melitvinov/Acidifier/Документация/Описание подкислителя.docx

# Подкислитель

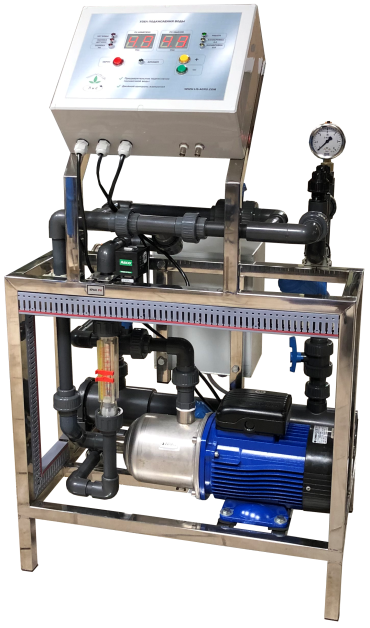
[picture p1: figure]

| Назначение Подкислитель – устройство, предназначенное для автоматического подкисления потока воды до заданного пользователем значения PH.

# Внешний вид, управление и индикация

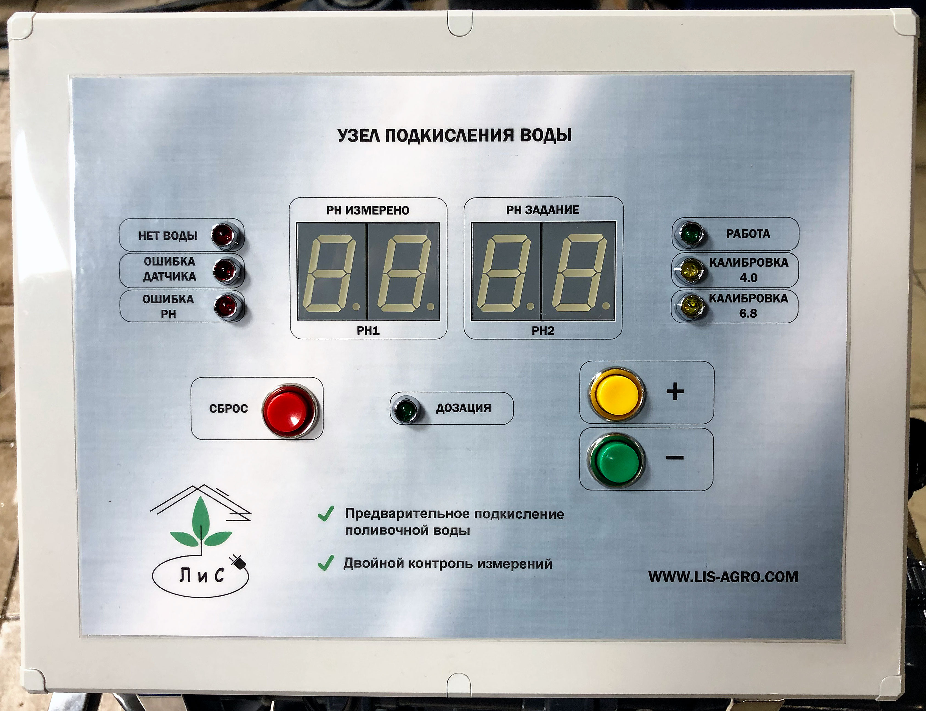
[picture p2: figure]

Рисунок 1

Внешний вид блока управления показан на рисунке 1. Кнопки [+] и[-] позволяют изменять заданное значение PH, а также переводить подкислитель в режим калибровки датчиков. Кнопка [СБРОС] предназначена для отмены режима калибровки, а также для сброса ошибок. Левый двухразрядный цифровой индикатор отображает текущее значение PH воды в режиме работы (полива или наполнения емкости), либо значение PH первого датчика в режиме калибровки. Правый двухразрядный цифровой индикатор отображает заданное пользователем значение PH воды в режиме работы (полива или наполнения емкости), либо значение PH второго датчика в режиме калибровки. Светодиоды отображают различные состояния работы прибора, а также наличие ошибок в работе.

# Работа в режиме подкисления воды

В этот режим подкислитель переходит после включения, либо после завершения (либо отмены) калибровки датчиков PH. Необходимым условием работы подкислителя является наличие потока воды. Когда поток воды есть, на блоке управления загорается светодиодный индикаторы «Работа», и включается встроенный насос.

Для задания нужного значения PH воды используйте кнопки [+] или [-]. Каждое нажатие на кнопку увеличивает, либо уменьшает заданное значение PH на величину 0,1. Правый двухразрядный цифровой индикатор отображает текущее заданное значение.

В этом режиме подкислитель работает пока есть поток воды и отсутствуют ошибки. При возникновении внутренних ошибок или отсутствии воды работа подкислителя останавливается.

# Ошибки, сброс ошибок

1. Ошибка датчиков возникает, если разница измеренных значений между первым и вторым датчиком больше 0,5.
2. Ошибка регулирования возникает, если за период времени (40 сек. по умолчанию) не удается выйти на заданное пользователем значение PH (в диапазоне +-0,5).
3. Отсутствие воды

При возникновении любой из перечисленных ошибок работа подкислителя останавливается.

Для сброса ошибок регулирования и ошибки датчиков (после устранения причины их возникновения) удерживайте кнопку «СБРОС» в течение 3 сек. Ошибка отсутствия воды сбросится автоматически после появления протока воды.

# Калибровка датчиков

В подкислителе используются два датчика PH. Перед началом использования подкислителя, а также в каждый период регламентных работ эти датчики надо откалибровать.

Калибровка производится следующим образом:

- На блоке управления нажать и удерживать одновременно кнопки [+][-] в течение 2-3 сек. При этом на блоке управления загорится светодиод «Калибровка 4.0», а на цифровых индикаторах будут текущие значения по каждому из датчиков, на левом для первого датчика, на правом – для второго.
- Оба датчика погружаются в раствор 4.01 (значение по умолчанию). Делается пауза около 1-2 мин. чтобы датчики адаптировались к раствору.
- Через 1-2 минуты нажать еще раз обе кнопки [+][-] в течение 2-3 сек. Светодиод «Калибровка 4.0» погаснет, а Светодиод «Калибровка 6.8» загорится. При этом для обоих датчиков будут зафиксированы значения калибровочной точки 4.0.
- Оба датчика погружаются в раствор 6.8 (значение по умолчанию). Делается пауза около 1-2 мин. чтобы датчики адаптировались к раствору.
- Через 1-2 минуты нажать еще раз обе кнопки [+][-] в течение 2-3 сек. Светодиод «Калибровка 6.8» погаснет. При этом для обоих датчиков будут зафиксированы значения калибровочной точки 6.8, а подкислитель вернется в состояние работы.

# Эксплуатационные параметры

Давление в системе | 2 кгс
Продолжительность работы | круглосуточная
