melitvinov/Acidifier/PCAD/Перечень элементов Acidifier-v7.xlsx

RefDes | ComponentName | Value | PatternName
A1 | AM2S-1205SZ | AM2S-1205SZ | AM2S-1205SZ
D2 | FM24V02 | FM24V02 | SO-G8
VT3 | BC857_SOT23 |  | SOT-23A
C2 | CTB | 100.0x10V | CTB
C3 | CTB | 100.0x10V | CTB
C1 | CTB | 100.0x20V | CTB
C12 | C_400V | 0,33 mkF | C_400V
C13 | C_400V | 0,33 mkF | C_400V
C7 | C_0805 | 4.7 mkF | 0805
C8 | C_0805 | 4.7mkF | 0805
C9 | C_0805 | 4.7mkF | 0805
C4 | C_0805 | 100nF | 0805
C5 | C_0805 | 100nF | 0805
C6 | C_0805 | 100nF | 0805
C10 | C_0805 | 100nF | 0805
C11 | C_0805 | 100nF | 0805
XP1 | IDC2X5M |  | IDC10M
XP2 | IDC2X5M |  | IDC10M
VT1 | IRLML2502 | IRLML2502 | SOT-23
VT2 | IRLML2502 | IRLML2502 | SOT-23
VT4 | IRLML2502 | IRLML2502 | SOT-23
A2 | IRM-05 |  | IRM-05
D3 | ISO3082 |  | SO-16-W
J1 | JMP1 |  | PLS-2
J2 | JMP1 |  | PLS-2
HL_ALARM1 | LED_1206 | RED | LED_1206
HL_REGIMP1 | LED_1206 | RED | LED_1206
HL_WATER | LED_1206 | RED | LED_1206
HL1 | LED_1206 | RED | LED_1206
HL_PUMP1 | LED_1206 | YELLOW | LED_1206
D1 | LM1117-3.3V | LM1117-3.3V | SOT223
D6 | MOCD207M |  | SO-G8
XS1 | PBD-8 |  | PBD-8
XS2 | PBD-8 |  | PBD-8
P3 | ESR2002400300 |  | RELAY_ESR2002400300
P1 | NRP05_C |  | RELAY_NRP05_C
P2 | NRP05_C |  | RELAY_NRP05_C
R17 | R_2W_V | 100 | R_2W_V
R20 | R_2W_V | 100 | R_2W_V
R6 | R_0805 | 1k | 0805
R7 | R_0805 | 1k | 0805
R8 | R_0805 | 1k | 0805
R9 | R_0805 | 1k | 0805
R18 | R_0805 | 1k | 0805
R19 | R_0805 | 1k | 0805
R21 | R_0805 | 1k | 0805
R22 | R_0805 | 1k | 0805
R23 | R_0805 | 1k | 0805
R24 | R_0805 | 1k | 0805
R25 | R_0805 | 1k | 0805
R27 | R_0805 | 1k | 0805
R28 | R_0805 | 1k | 0805
R31 | R_0805 | 1k | 0805
R32 | R_0805 | 1k | 0805
R1 | R_0805 | 10k | 0805
R2 | R_0805 | 10k | 0805
R26 | R_0805 | 10k | 0805
R29 | R_0805 | 10k | 0805
R30 | R_0805 | 100 | 0805
R3 | R_0805 | 510 | 0805
R4 | R_0805 | 510 | 0805
R5 | R_0805 | 510 | 0805
R10 | R_0805 | 510 | 0805
R11 | R_0805 | 510 | 0805
R12 | R_0805 | 510 | 0805
R13 | R_0805 | 510 | 0805
R14 | R_0805 | 510 | 0805
R15 | R_0805 | 510 | 0805
R16 | R_0805 | 510 | 0805
D4 | STM32F105_LQFP64 | STM32F105 | QFP-64
SW1 | SW_ERD716BM06Z | ERD716BM06Z | ERD716BM06Z
D5 | ULN2803A | ULN2803 | SO-G18
VD2 | VD_BAT54WS |  | SOD323
VD3 | VD_BAT54WS |  | SOD323
VD4 | VD_BAT54WS |  | SOD323
VD5 | VD_BAT54WS |  | SOD323
XS_220V1 | XS_DG142V-5.08-02P |  | XS_DG142V-5.08-02P
XS_ALARM1 | XS_DG142V-5.08-02P |  | XS_DG142V-5.08-02P
XS_BTN1 | XS_DG142V-5.08-02P |  | XS_DG142V-5.08-02P
XS_BTN2 | XS_DG142V-5.08-02P |  | XS_DG142V-5.08-02P
XS_LED1 | XS_DG142V-5.08-02P |  | XS_DG142V-5.08-02P
XS_LED2 | XS_DG142V-5.08-02P |  | XS_DG142V-5.08-02P
XS_LED3 | XS_DG142V-5.08-02P |  | XS_DG142V-5.08-02P
XS_LED4 | XS_DG142V-5.08-02P |  | XS_DG142V-5.08-02P
XS_PUMP1 | XS_DG142V-5.08-02P |  | XS_DG142V-5.08-02P
XS_REG_CTRL1 | XS_DG142V-5.08-02P |  | XS_DG142V-5.08-02P
XS_RS1 | XS_DG142V-5.08-02P |  | XS_DG142V-5.08-02P
XS_WATER1 | XS_DG142V-5.08-02P |  | XS_DG142V-5.08-02P
