melitvinov/Acidifier/PCAD/BOM/BOM_Acidifier - LCD v3.xlsx

ТИП | ИМЯ(ЗНАЧ) | КОРПУС | КОЛ-ВО | ПРОИЗВ(1). | НОМ.НОМЕР(1) | ПРОИЗВ(2). | НОМ.НОМЕР(2) | REF DES
Конденсатор SMD | 100nF | SMD_0805 | 4 | Walsin | 0805 B 104 K 250 | --- No Data --- |  | C3, C4, C5, C6
Конденсатор Tantal SMD | 100.0uFx10V | SMD_Type_B | 1 | Kemet | TAJ B 107 M 010 | AVX | TAJB107M010RNJ | C1
Микросхема | 74HC4094 | SO-G16 | 4 | NXP Semiconductors | 74HC4094D | --- No Data --- |  | D1, D2, D3, D4
Резистор SMD | 100 | SMD_0805 | 28 | Walsin | WR08 X 101 J T | --- No Data --- |  | R1, R2, R3, R4, R5, R6, R7, R9, R11, R13, R14, R16, R18, R19, R23, R24, R26, R27, R28, R30, R32, R34, R35, R36, R37, R38, R39, R40
Резистор SMD | 200 | SMD_0805 | 4 | Walsin | WR08 X 201 J T | --- No Data --- |  | R8, R21, R33, R41
