melitvinov/Acidifier/PCAD/BOM/BOM_Acidifier-v7.xlsx

ТИП | ИМЯ(ЗНАЧ) | КОРПУС | КОЛ-ВО | ПРОИЗВ(1). | НОМ.НОМЕР(1) | ПРОИЗВ(2). | НОМ.НОМЕР(2) | REF DES
Диод | BAT54WS | SOD323 | 4 | Diotec | BAT54WS | --- No Data --- |  | VD2, VD3, VD4, VD5
Конденсатор DIP | 0,33 mkF | C_400V | 2 | --- No Data --- |  | --- No Data --- |  | C12, C13
Конденсатор SMD | 100nF | SMD_0805 | 5 | Walsin | 0805 B 104 K 250 | --- No Data --- |  | C4, C5, C6, C10, C11
Конденсатор SMD | 4.7uF | SMD_0805 | 3 | Walsin | 0805 X 475 K 100 | --- No Data --- |  | C7, C8, C9
Конденсатор Tantal SMD | 100.0uFx10V | SMD_Type_B | 2 | Kemet | TAJ B 107 M 010 | AVX | TAJB107M010RNJ | C2, C3
Конденсатор Tantal SMD | 100.0uFx20V | SMD_Type_B | 1 | Kemet | TAJ B 107 M 020 | --- No Data --- |  | C1
Микросхема | FM24V02 | SO-G8 | 1 | Cypress Semiconductor | FM24V02-G | --- No Data --- |  | D2
Микросхема | ISO3082 | SO-16-W | 1 | Texas Instruments | ISO3082DW | --- No Data --- |  | D3
Микросхема | LM1117-3.3V | SOT223 | 1 | Texas Instruments | LM1117MPX-3.3 | --- No Data --- |  | D1
Микросхема | STM32F105 | QFP-64 | 1 | ST | STM32F105RC | --- No Data --- |  | D4
Микросхема | ULN2803A | SO-G18 | 1 | Texas Instruments | ULN2803ADW | --- No Data --- |  | D5
Модуль | AM2S-1205SZ | AM2S-1205SZ | 1 | --- No Data --- |  | --- No Data --- |  | A1
Модуль | IRM-05 | IRM-05 | 1 | --- No Data --- |  | --- No Data --- |  | A2
Оптрон | MOCD207 | SO-G8 | 1 | ON Semiconductor | MOCD207M | --- No Data --- |  | D6
Переключатель | ERD716BM06Z | ERD7 | 1 | ECE | ERD716BM06Z | --- No Data --- |  | SW1
Разъем | DG142V-5.08-02P | DG142V-5.08-02P | 12 | --- No Data --- |  | --- No Data --- |  | XS_220V1, ...
Резистор DIP | 100 | 2W_V | 1 | --- No Data --- |  | --- No Data --- |  | R17, R20
Резистор SMD | 100 | SMD_0805 | 1 | Walsin | WR08 X 101 J T | --- No Data --- |  | R30
Резистор SMD | 510 | SMD_0805 | 10 | Walsin | WR08 X 511 J T | --- No Data --- |  | R3, R4, R5, R10, R11, R12, R13, R14, R15, R16
Резистор SMD | 10k | SMD_0805 | 4 | Walsin | WR08 X 103 J T | --- No Data --- |  | R1, R2, R26, R29
Резистор SMD | 1k | SMD_0805 | 15 | Walsin | WR08 X 102 J T | --- No Data --- |  | R6, R7, R8, R9, R18, R19, R21, R22, R23, R24, R25, R27, R28, R31, R32
Реле | ESR2002400300 | ESR2002400300 | 1 | --- No Data --- |  | --- No Data --- |  | P3
Реле | NRP05_C | NRP05 | 2 | --- No Data --- |  | --- No Data --- |  | P1, P2
Светодиод SMD | LED_RED | SMD_1206 | 4 | Kingbright | KPTD-3216SECK | Foshan NationStar Optoelectronics | FC-3215HRK-620D | HL1, HL_ALARM1, HL_REGIMP1, HL_WATER
Светодиод SMD | LED_YELLOW | SMD_1206 | 1 | Kingbright |  | --- No Data --- |  | HL_PUMP1
Транзистор | BC857 | SOT-23 | 1 | NXP Semiconductors | BC857 | --- No Data --- |  | VT3
Транзистор | IRLML2502 | SOT-23 | 3 | International Rectifier | IRLML2502TRPBF | --- No Data --- |  | VT1, VT2, VT4
