melitvinov/Acidifier/PCAD/Перечень элементов Acidifier LCD-v3.xlsx

RefDes | ComponentName | PatternName | Value
C1 | CTB | CTB | 100.0x10V
C3 | C_0805 | 0805 | 100 nF
C4 | C_0805 | 0805 | 100 nF
C5 | C_0805 | 0805 | 100 nF
C6 | C_0805 | 0805 | 100 nF
D1 | 74HC4094 | SO16
D2 | 74HC4094 | SO16
D3 | 74HC4094 | SO16
D4 | 74HC4094 | SO16
DLED1 | DIG_SC10-21 | DIG_SC10-21
DLED2 | DIG_SC10-21 | DIG_SC10-21
DLED3 | DIG_SC10-21 | DIG_SC10-21
DLED4 | DIG_SC10-21 | DIG_SC10-21
R1 | R_0805 | 0805 | 100
R2 | R_0805 | 0805 | 100
R3 | R_0805 | 0805 | 100
R4 | R_0805 | 0805 | 100
R5 | R_0805 | 0805 | 100
R6 | R_0805 | 0805 | 100
R7 | R_0805 | 0805 | 100
R8 | R_0805 | 0805 | 200
R9 | R_0805 | 0805 | 100
R11 | R_0805 | 0805 | 100
R13 | R_0805 | 0805 | 100
R14 | R_0805 | 0805 | 100
R16 | R_0805 | 0805 | 100
R18 | R_0805 | 0805 | 100
R19 | R_0805 | 0805 | 100
R21 | R_0805 | 0805 | 200
R23 | R_0805 | 0805 | 100
R24 | R_0805 | 0805 | 100
R26 | R_0805 | 0805 | 100
R27 | R_0805 | 0805 | 100
R28 | R_0805 | 0805 | 100
R30 | R_0805 | 0805 | 100
R32 | R_0805 | 0805 | 100
R33 | R_0805 | 0805 | 200
R34 | R_0805 | 0805 | 100
R35 | R_0805 | 0805 | 100
R36 | R_0805 | 0805 | 100
R37 | R_0805 | 0805 | 100
R38 | R_0805 | 0805 | 100
R39 | R_0805 | 0805 | 100
R40 | R_0805 | 0805 | 100
R41 | R_0805 | 0805 | 200
XP1 | IDC2X5M | IDC10M | IDC2X5M
