melitvinov/Acidifier/Документация/Внешний вид вкладки подкислителя в ПО DeviceSetup.JPG

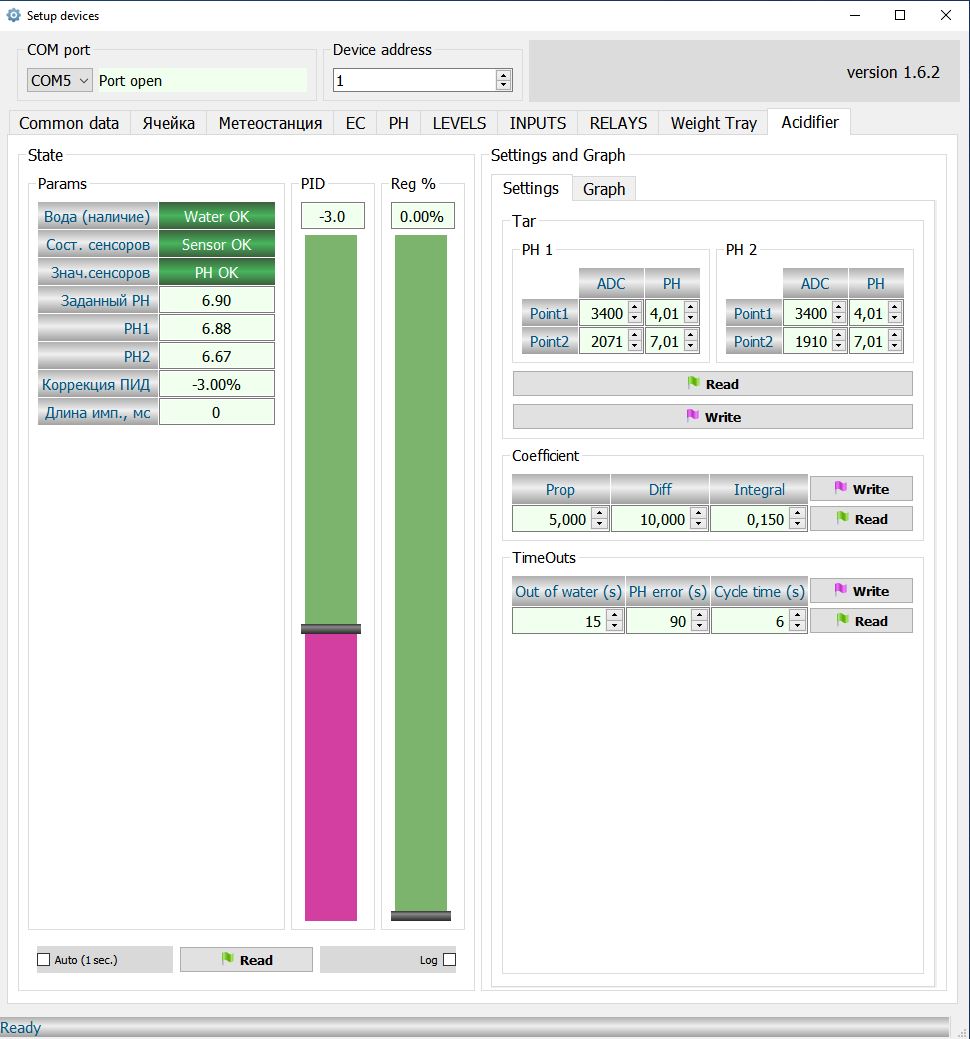
Документация/Внешний вид вкладки подкислителя в ПО DeviceSetup.JPG
