melitvinov/Acidifier/PCAD/Монтажная схема Acidifier-v7.pdf

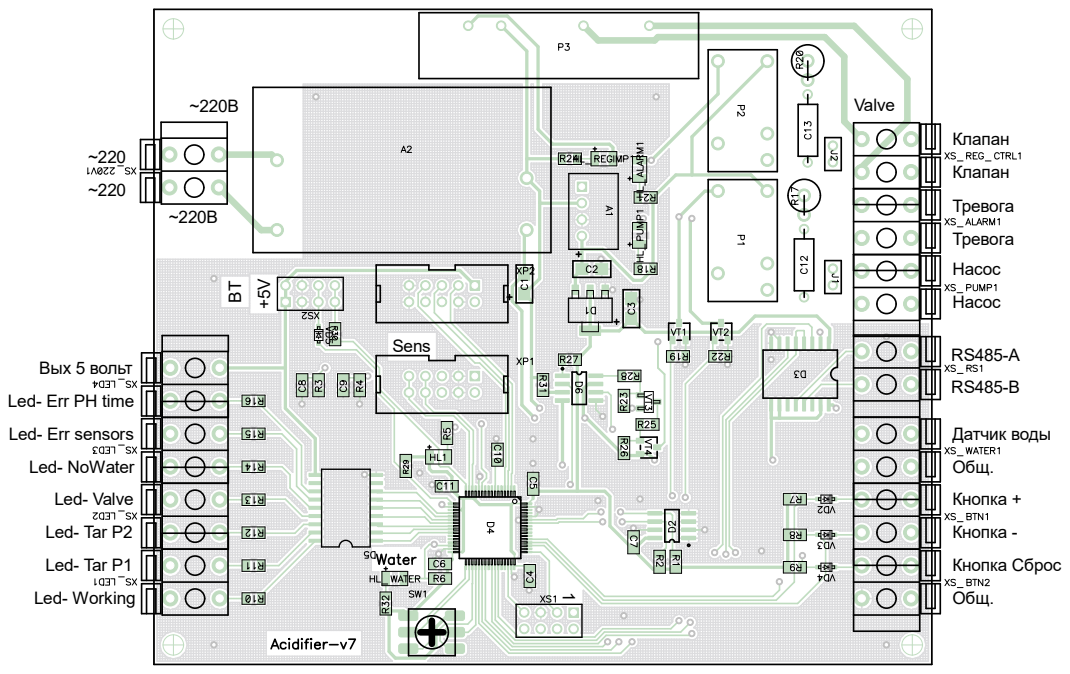
[picture p4: page 1]
Общ.; Кнопка Сброс; Кнопка +; Насос; Тревога; Клапан; Кнопка -; Датчик воды; Sens; Valve BT

Вых 5 вольт
Led- Err PH time
Led- Err sensors
Led- NoWater
Led- Valve
Led- Tar P2
Led- Tar P1
Led- Working
