melitvinov/Acidifier/Функциональная схема подкислителя.pdf

## Регулировка PH

# Функциональная схема подкислителя

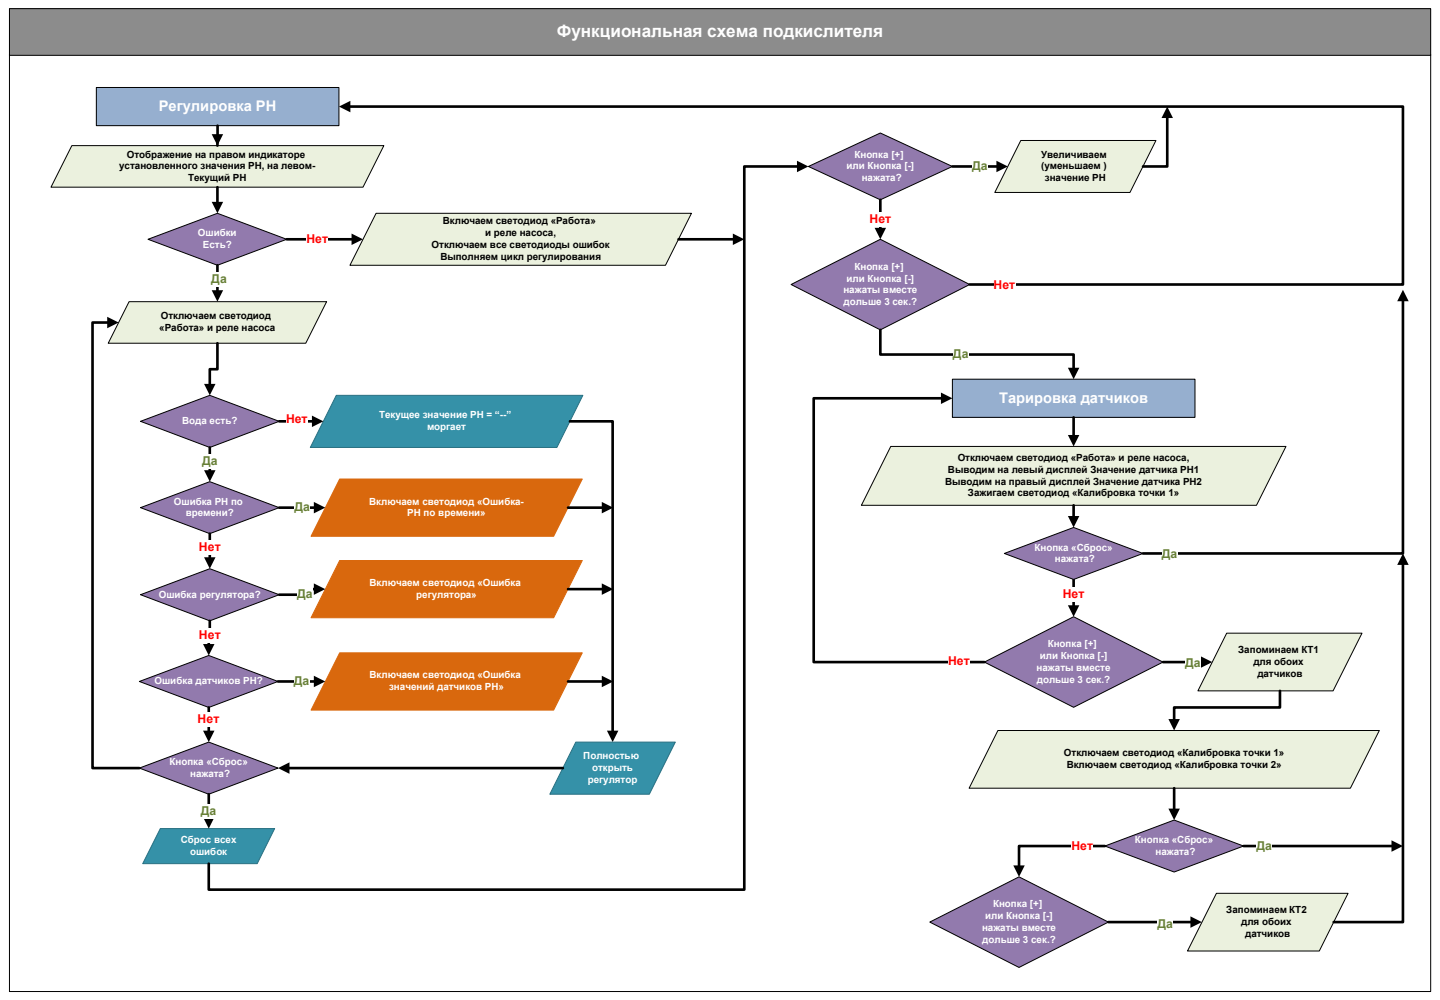
[picture p5: page 1]
Текущий PH; Вода есть?; моргает; Нет; Кнопка [+] или Кнопка [-] нажата?; Увеличиваем (уменьшаем ) значение PH; Кнопка [+] или Кнопка [-] нажаты вместе дольше 3 сек.?; Тарировка датчиков; времени?; регулятора»; Ошибка регулятора?; и реле насоса,; Запоминаем КТ1 для обоих датчиков; Кнопка «Сброс» нажата?; Сброс всех ошибок; Кнопка «Сброс»; нажата?; Запоминаем КТ2 для обоих датчиков; Ошибки Есть?; Полностью открыть регулятор

Отображение на правом индикаторе
установленного значения PH, на левом-

Включаем светодиод «Работа»

Отключаем все светодиоды ошибок
Выполняем цикл регулирования

Отключаем светодиод
«Работа» и реле насоса

Текущее значение PH = “--”

Отключаем светодиод «Работа» и реле насоса,
Выводим на левый дисплей Значение датчика PH1
Выводим на правый дисплей Значение датчика PH2
Зажигаем светодиод «Калибровка точки 1»

Ошибка PH по

Включаем светодиод «Ошибка-

PH по времени»

Включаем светодиод «Ошибка

Ошибка датчиков PH?

значений датчиков PH»

Отключаем светодиод «Калибровка точки 1»
Включаем светодиод «Калибровка точки 2»
