melitvinov/Acidifier/PCAD/Монтажная схема Acidifier LCD-v3.pdf

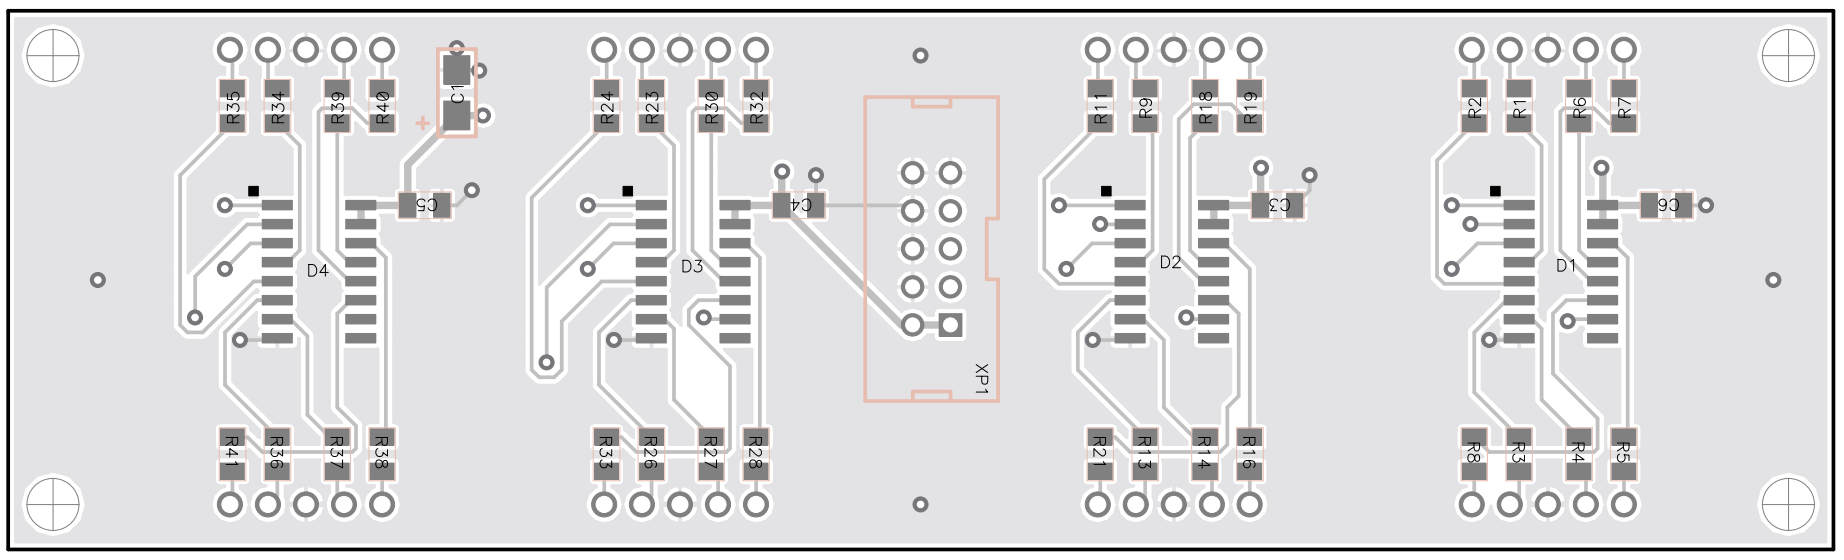
[picture p6: page 1]
