melitvinov/Acidifier/(list of files, drawings)

Other design files:
PCAD/Acidifier - LCD_v3.pcb
PCAD/Acidifier-v7.pcb
