melitvinov/Acidifier/SOFT/Sources/Regulator.c

/***********************************************************************************
* Наименование модуля	: Управление регулятором PH
*-----------------------------------------------------------------------------------
* Версия				: 1.0
* Автор					: Тимофеев
* Дата создания			: 10.03.2021
************************************************************************************/

//--- INCLUDES -------------------
#include "Regulator.h"
#include "Leds.h"
#include "AnaInputs.h"
#include "leds-dig.h"
#include "Rs485.h"

//--- CONSTANTS ------------------

const float K_PROP_DEFAULT 					= 7.0;
const float K_DIFF_DEFAULT 					= 0.0;
const float K_INTEGRAL_DEFAULT 				= 0.0;
const uint16_t REG_CYCLETIME_SEC_DEFAULT 	= 6;

const uint16_t MIN_REG_CYCLETIME_SEC 		= 3;	// минимальный период регулятора в секундах
const uint16_t MAX_REG_CYCLETIME_SEC 		= 10;	// максимальный период регулятора в секундах

const uint32_t TIMEOUT_SENSORS_TOO_DIFF_MS 	= 30000; // тайм-аут в мс для ошибки при разнице показаний датчиков PH больше порогового значения	
const float MAX_PH_DELTA_FOR_ERROR			= 1.0;	// отклонение от задания для старта таймера ошибки по регулированию pH
//const uint16_t MIN_REGULATOR_PERCENT 		= 5;	// минимально возможное открытие регулятора в %
//const uint16_t MAX_REGULATOR_PERCENT		= 95;	// максимально возможное открытие регулятора в %
const uint16_t MIN_REGULATOR_PERCENT 		= 0;	// минимально возможное открытие регулятора в %
const uint16_t MAX_REGULATOR_PERCENT		= 100;	// максимально возможное открытие регулятора в %
const uint16_t MAX_ABS_PID 					= 30;	// максимально возможное значение PID

const int MIN_REGIMP_PACK_TIME_MS = 250;			// минимальная длина импульса регулятора в пачке
const int MIN_REGIMP_ONE_TIME_MS = 200;				// минимальная длина импульса регулятора в пачке

//--- GLOBAL VARIABLES -----------
extern float g_Sensor_PH;					// текущее значение PH с датчиков
extern float g_Setup_PH;					// заданное пользователем значение PH

extern bool g_isNoWater;
//bool is_WaterOk_prev = false;
extern bool g_isErrTimeoutSetupPh;
extern bool g_isErrSensors;

float g_K_INTEGRAL;
float g_K_DIFF;
float g_K_PROP;

uint16_t g_TIMEOUT_REGULATOR_ON_SEC;	// задержка включения регулятора и насоса после подачи воды (сек.)
uint16_t g_TIMEOUT_ERROR_PH_SEC;		// длительность отклонения величины PH от заданного до установки ошибки (сек.)
uint16_t g_REGULATOR_CYCLETIME_SEC;		// период регулирования (сек)
uint16_t g_DELAY_PUMP_OFF_SEC;			// задержка отключения насоса (сек)

float g_flRegPercentOn;					// текущее (последнее значение процента открытия регулятора в %)
float g_PID_Value;						// текущее значение PID
float g_flDeltaPercent;					// текущее значение уменьшения или увеличения процента открытия
int g_ImpulseTime_ms;					// длительность открытия клапана в мс.
float g_PID_IntegralValue = 0;			// накопленный интегральный компонент для расчета PID
float g_prev_PhValue = 7;				// предыдущее значение Ph  для расчета PID

//int g_TimeToStartReg_ms;				// оставшееся время до начала дозации после включения насоса в мс
//int g_TimeToStartCalcPID_ms;			// оставшееся время до начала вычисления PID в мс
bool g_RegulatorStarted;				// флаг - регулятор работает
bool g_CalcPidStarted;					// флаг - расчет PID работает

// таблица оптимальных начальных значений регулятора для трех ph значений 
TOptTablePoint g_OptTablePoints[3];		

//TimerHandle_t TimerPump;
TimerHandle_t TimerRegulatorStartDelay;
//TimerHandle_t TimerCalcPid;

extern uint8_t g_WdtRegulator;
extern uint8_t g_WdtKlapan;
extern uint8_t g_WdtPid;

//--- FUNCTIONS ------------------
extern int ReadWorkMode( uint16_t idx );

void Thread_Klapan( void *pvParameters );
void switch_VALVE( uint8_t on );
void switch_PUMP( uint8_t on );

/*******************************************************
Функция		: Остановка насоса по таймеру
Возвр. знач.: нет
********************************************************/
//void OnTimerPump( TimerHandle_t xTimer )
//{
//	configASSERT( xTimer );
//	
//	xTimerStop( xTimer, 0 );
//	switch_PUMP(0);
//}

/*******************************************************
Функция		: Старт регулятора по таймеру
Возвр. знач.: нет
********************************************************/
void OnTimerRegulatorStartDelay( TimerHandle_t xTimer )
{
	configASSERT( xTimer );
	
	xTimerStop( xTimer, 0 );

	// Устанавливаем значение регулятора
	int index;
	if( g_Setup_PH >= 6 ) index = 0;
	else if( g_Setup_PH >= 5 ) index = 1;
	else index = 2;
	if( g_OptTablePoints[index].ph_setup_user != 0xFFFF && g_OptTablePoints[index].reg_value_opt_calc != 0xFFFF )
	{
		g_flRegPercentOn = ((float)g_OptTablePoints[index].reg_value_opt_calc) / 10.0;
		g_flRegPercentOn /= 2;	// в начале регулирования ставим только половину сохраненного значения
	}
	else
		g_flRegPercentOn = ((float)g_OptTablePoints[index].reg_value_opt_def) / 10.0;

	if( g_flRegPercentOn > MAX_REGULATOR_PERCENT || g_flRegPercentOn < MIN_REGULATOR_PERCENT )
	{
		// !!! Ошибка
		g_flRegPercentOn = MIN_REGULATOR_PERCENT;			// если при начальной установке положения регулятора произошла ошибка, ставим 5% открытия
	}
	
//	xTimerStart( TimerCalcPid, 0 );
	
	g_RegulatorStarted = true;
}

/*******************************************************
Функция		: Старт расчета PID по таймеру
Возвр. знач.: нет
********************************************************/
/*
void OnTimerCalcPid( TimerHandle_t xTimer )
{
	configASSERT( xTimer );
	
	xTimerStop( xTimer, 0 );
	g_CalcPidStarted = true;
}
*/

/*******************************************************
Функция		: Включение регулятора. (после подачи воды)
Возвр. знач.: нет
********************************************************/
void Regulator_START(void) 
{
	// Инициализируем переменные для расчета PID
	g_PID_Value = 0;					// текущее значение PID
	g_flDeltaPercent = 0;				// текущее значение уменьшения или увеличения процента открытия
	g_PID_IntegralValue = 0;			// накопленный интегральный компонент для расчета PID
	g_prev_PhValue = 7;					// предыдущее значение Ph  для расчета PID
	
	TickType_t timerPeriod = g_TIMEOUT_REGULATOR_ON_SEC > 0 ? (g_TIMEOUT_REGULATOR_ON_SEC * 1000) : 100;
	const TickType_t timerTryPeriod = 100;
	
	// устанавливаем таймер на старт процесса регулирования
	if( xTimerChangePeriod( TimerRegulatorStartDelay, timerPeriod, timerTryPeriod ) == pdPASS )
	{
		// The command was successfully sent.
		// OnTimerRegulatorStartDelay() вызовется после срабатывания таймера
	}
	else
	{
		// The command could not be sent, even after waiting for 100 ticks
		// to pass.  Take appropriate action here.
		OnTimerRegulatorStartDelay( TimerRegulatorStartDelay );
	}
	
	// Останавливаем таймер насоса
//	configASSERT( TimerPump );
//	xTimerStop( TimerPump, 0 );

	// Включаем насос
	switch_PUMP( 1 );
}

void Regulator_STOP(void) 
{
//	configASSERT( TimerPump )
//	configASSERT( TimerCalcPid )
	configASSERT( TimerRegulatorStartDelay )

	xTimerStop( TimerRegulatorStartDelay, 0 );
//	xTimerStop( TimerCalcPid, 0 );
	
	g_flDeltaPercent = 0;
	g_flRegPercentOn = MIN_REGULATOR_PERCENT;
	g_PID_Value = 0;
	g_PID_IntegralValue = 0;
	g_RegulatorStarted = false;
	g_CalcPidStarted = false;
	
//	// Выключаем насос через задержку
//	xTimerChangePeriod( TimerPump, g_DELAY_PUMP_OFF_SEC > 0 ? (g_DELAY_PUMP_OFF_SEC * 1000) : 100, 0 );
//	
//	BaseType_t result = xTimerStart( TimerPump, 50 );
//	if( result != pdPASS )
//	{ /* The timer could not be set into the Active
//	   state. */
//	
//		// через таймер не вышло, отключаем сразу
		switch_PUMP( 0 ); 
//	}
}

/*******************************************************
Функция		: Вкл. / выкл. насоса
Параметр 1	: нет
Возвр. знач.: нет
********************************************************/
void switch_PUMP( uint8_t on )
{
	Led_OnOff( LED_WORK_OK, on );
	GPIO_PinWrite( PORT_RELAY_PUMP, PIN_RELAY_PUMP, on );
}

bool IsPumpTurnON( void )
{
	bool isOn = GPIO_PinRead( PORT_RELAY_PUMP, PIN_RELAY_PUMP ) == 0 ? false : true;
	return isOn;
}
/*******************************************************
	Возвращает состояние датчика протока воды
********************************************************/
bool IsWaterOk( void )
{
	bool isOk;
	isOk = ( GPIO_PinRead( PORT_SENS_WATER, PIN_SENS_WATER ) == 0 );
	
	return isOk;
}

/*******************************************************
	Возвращает флаг нужно сейчас регулировать или нет
********************************************************/
bool IsRegulatingOn( void )
{
	bool isOn;
	
	isOn = (!g_isNoWater && !g_isErrSensors && !g_isErrTimeoutSetupPh && g_RegulatorStarted );
	
	return isOn;
}

/*******************************************************
Функция		: Вкл. / выкл. клапана
Параметр 1	: нет
Возвр. знач.: нет
********************************************************/
void switch_VALVE( uint8_t on )
{
	if( on == 0 ) {
		Led_OnOff( LED_VALVE, 0 );
		GPIO_PinWrite( PORT_RELAY_VALVE , PIN_RELAY_VALVE, 1 );
	}
	else /*if( IsPumpTurnON() )*/ {
		Led_OnOff( LED_VALVE, 1 );
		GPIO_PinWrite( PORT_RELAY_VALVE , PIN_RELAY_VALVE, 0 );
	}
}

void setUpDefaultOptTable( void )
{
	// Инициализируем значениями по умолчанию таблицу оптимальных настроек
	for( int i=0; i<3; i++ )
	{
		g_OptTablePoints[i].ph_setup_def = 65 - (i*10);				// PH 		= 6.5	5.5		4.5
		g_OptTablePoints[i].reg_value_opt_def = (10 + (i*20)) * 10; // Value 	= 10	30		50
		g_OptTablePoints[i].ph_setup_user = 0xFFFF;					// PH 		= 0xFFFF - нет значения
		g_OptTablePoints[i].reg_value_opt_calc = 0xFFFF;			// Value 	= 0xFFFF - нет значения
	}
	FM24_WriteBytes( EEADR_OPT_TABLE, (uint8_t*) &g_OptTablePoints, sizeof(g_OptTablePoints) );
}

/*******************************************************
Функция		: Инициализация железа
Параметр 1	: нет
Возвр. знач.: нет
********************************************************/
void Reg_Init(void)
{
	GPIO_PinRemapConfig( GPIO_Remap_SWJ_JTAGDisable, ENABLE );

	// Перевод вывода на вход с подтяжкой к VCC для датчика воды
	GPIO_PinConfigure( PORT_SENS_WATER, PIN_SENS_WATER, GPIO_IN_PULL_UP, GPIO_MODE_INPUT );
	
	// Перевод выводов реле насоса и клапана на выход
	GPIO_PinConfigure( PORT_RELAY_PUMP, PIN_RELAY_PUMP, GPIO_OUT_PUSH_PULL, GPIO_MODE_OUT2MHZ );
	GPIO_PinConfigure( PORT_RELAY_VALVE, PIN_RELAY_VALVE, GPIO_OUT_PUSH_PULL, GPIO_MODE_OUT2MHZ );
	
	// Отключение насоса и клапана
	GPIO_PinWrite( PORT_RELAY_PUMP, PIN_RELAY_PUMP, 0 );
	Led_OnOff( LED_WORK_OK, 0 );
	switch_VALVE( 0 );
	
	// Загружаем коэффициенты для расчета
	uint16_t Koef[3];
	bool needSetupDef = false;
	
	if( !FM24_ReadWords( EEADR_COEF_PROP, &(Koef[0]), 3 ) )
		needSetupDef = true;
	else if( Koef[0] == 0 ) //|| Koef[1] == 0 )
		needSetupDef = true;

	if( needSetupDef )
	{
		g_K_PROP = K_PROP_DEFAULT;
		g_K_INTEGRAL = K_INTEGRAL_DEFAULT;
		g_K_DIFF = K_DIFF_DEFAULT;
		Koef[0] = g_K_PROP * 1000;
		Koef[1] = g_K_INTEGRAL * 1000;
		Koef[2] = g_K_DIFF * 1000;
		
		FM24_WriteWords( EEADR_COEF_PROP, &(Koef[0]), 3 );
	}
	else
	{
		g_K_PROP = (float)Koef[0] / 1000.0;
		g_K_INTEGRAL = (float)Koef[1] / 1000.0;
		g_K_DIFF = (float)Koef[2] / 1000.0;
		
	}

	if( !FM24_ReadWords( EEADR_TIMEOUT_REGULATOR_ON_SEC, &g_TIMEOUT_REGULATOR_ON_SEC, 1 ) || g_TIMEOUT_REGULATOR_ON_SEC == 0 )
	{
		g_TIMEOUT_REGULATOR_ON_SEC = 5;
		FM24_WriteWords( EEADR_TIMEOUT_REGULATOR_ON_SEC, &g_TIMEOUT_REGULATOR_ON_SEC, 1 );
	}

	if( !FM24_ReadWords( EEADR_TIMEOUT_ERROR_PH_SEC, &g_TIMEOUT_ERROR_PH_SEC, 1 ) || g_TIMEOUT_ERROR_PH_SEC == 0 )
	{
		g_TIMEOUT_ERROR_PH_SEC = 90;
		FM24_WriteWords( EEADR_TIMEOUT_ERROR_PH_SEC, &g_TIMEOUT_ERROR_PH_SEC, 1 );
	}

	if( !FM24_ReadWords( EEADR_REG_CYCLETIME_SEC, &g_REGULATOR_CYCLETIME_SEC, 1 ) || g_REGULATOR_CYCLETIME_SEC == 0 )
	{
		g_REGULATOR_CYCLETIME_SEC = REG_CYCLETIME_SEC_DEFAULT;
		FM24_WriteWords( EEADR_REG_CYCLETIME_SEC, &g_REGULATOR_CYCLETIME_SEC, 1 );
	}
	
	// инициализируем таблицу оптимальных значений регулятора в зависимости от установки PH
	if( !FM24_ReadBytes( EEADR_OPT_TABLE, (uint8_t*) &g_OptTablePoints, sizeof(g_OptTablePoints) ) )
	{
		setUpDefaultOptTable();
	}
	else 
	{
		bool needDef = false;
		for( int i=0; i<3; i++ )
			needDef |= g_OptTablePoints[i].ph_setup_def < 40 || g_OptTablePoints[i].ph_setup_def > 70;

		if( needDef )
			setUpDefaultOptTable();
	}

	if( !FM24_ReadWords( EEADR_DELAY_PUMP_OFF_SEC, &g_DELAY_PUMP_OFF_SEC, 1 ) || ( !g_DELAY_PUMP_OFF_SEC ) )
	{
		g_DELAY_PUMP_OFF_SEC = 5;
		FM24_WriteWords( EEADR_DELAY_PUMP_OFF_SEC, &g_DELAY_PUMP_OFF_SEC, 1 );
	}
	if( g_DELAY_PUMP_OFF_SEC > 20 ) {
		g_DELAY_PUMP_OFF_SEC = 20;
		FM24_WriteWords( EEADR_DELAY_PUMP_OFF_SEC, &g_DELAY_PUMP_OFF_SEC, 1 );
	}		
}

/*******************************************************
Поток		: Расчет величины PID 
Параметр 1	: не используется
Возвр. знач.: бесконечный цикл
********************************************************/
/*
void Thread_Pid( void *pvParameters )
{
	float prop_value, integ_value, diff_value, error_ph, tmp_Pid;

	TickType_t xLastWakeTime  = xTaskGetTickCount();
	const TickType_t PERIOD_MS = 1000;
	
	for(;;)
	{
		g_WdtPid = 1;
		
		vTaskDelayUntil( &xLastWakeTime, PERIOD_MS );

		if( IsRegulatingOn() && g_CalcPidStarted )
		{
			// при наличии воды и отсутсвии ошибок вычисляем величину PID
			// ошибка Ph
			error_ph = g_Sensor_PH - g_Setup_PH;
			// пропорциональный компонент
			prop_value = g_K_PROP * error_ph;
			
			// интегральный компонент
			integ_value =  g_K_INTEGRAL * error_ph;
			// добавляем накопленный интегральный компонент
			integ_value += g_PID_IntegralValue;
			// сохраняем текущее значение накопленного интегрального компонента
			g_PID_IntegralValue = integ_value;
			
			// дифференциальный компонент
			diff_value = g_Sensor_PH - g_prev_PhValue;
			diff_value *= g_K_DIFF;
			
			// сохраняем текущее значение Ph для будущих расчетов
			g_prev_PhValue = g_Sensor_PH;

			tmp_Pid = prop_value + integ_value + diff_value;
			
			if( fabs( tmp_Pid ) > MAX_ABS_PID )
			{
				if( tmp_Pid >= 0 ) 
					tmp_Pid = MAX_ABS_PID;
				else {
					tmp_Pid = MAX_ABS_PID;
					tmp_Pid *= -1.0;
				}
			}
			
			//tmp_Pid *= -1.0;

			g_PID_Value = tmp_Pid;
		}
	}
}
*/

void calc_pid( void ) 
{
	float prop_value, integ_value, diff_value, error_ph, tmp_Pid;
	
	// при наличии воды и отсутсвии ошибок вычисляем величину PID
	// ошибка Ph
	error_ph = g_Sensor_PH - g_Setup_PH;
	// пропорциональный компонент
	prop_value = g_K_PROP * error_ph;
	
	// интегральный компонент
	integ_value =  g_K_INTEGRAL * error_ph;
	// добавляем накопленный интегральный компонент
	integ_value += g_PID_IntegralValue;
	// сохраняем текущее значение накопленного интегрального компонента
	g_PID_IntegralValue = integ_value;
	
	// дифференциальный компонент
	diff_value = g_Sensor_PH - g_prev_PhValue;
	diff_value *= g_K_DIFF;
	
	// сохраняем текущее значение Ph для будущих расчетов
	g_prev_PhValue = g_Sensor_PH;

	tmp_Pid = prop_value + integ_value + diff_value;
	
	if( fabs( tmp_Pid ) > MAX_ABS_PID )
	{
		if( tmp_Pid >= 0 ) 
			tmp_Pid = MAX_ABS_PID;
		else {
			tmp_Pid = MAX_ABS_PID;
			tmp_Pid *= -1.0;
		}
	}
	
	//tmp_Pid *= -1.0;

	g_PID_Value = tmp_Pid;
}

/*******************************************************
Поток		: Управление клапаном дозации
Параметр 1	: не используется
Возвр. знач.: бесконечный цикл
********************************************************/
void Thread_Klapan( void *pvParameters )
{
	int impHigh_TimeMs, impLow_TimeMs, restTimeMs, delayMs;
	
	switch_VALVE(0);
	g_PID_IntegralValue = 0;
	g_PID_Value = 0;
	
	vTaskDelay( 1000 );

	TickType_t xLastWakeTime, xCurrTicks, xTickToNextCycle;
	for(;;)
	{
		g_WdtKlapan = 1;
		
		// Проверяем что процесс регулирования разрешен
		if( !IsRegulatingOn() )
		{
			// Если нет, закрываем клапан и ждем дальше
			//switch_VALVE(0);

			vTaskDelay(50);
			continue;
		}

		// Запоминаем время начала цикла дозации
		xLastWakeTime = xTaskGetTickCount();
		
		// вычисляем Pid
		calc_pid();
		
		// насос включен, вычисляем параметры импульсов
		g_flDeltaPercent = g_PID_Value;
		g_flRegPercentOn += g_flDeltaPercent;
		
		if( g_flRegPercentOn > MAX_REGULATOR_PERCENT )
			g_flRegPercentOn = MAX_REGULATOR_PERCENT;
		if( g_flRegPercentOn < MIN_REGULATOR_PERCENT )
			g_flRegPercentOn = MIN_REGULATOR_PERCENT;

//!!! -- Тут зафиксирована длина цикла = 3 сек.		
// Отменено в прошивке 1.09		g_REGULATOR_CYCLETIME_SEC = 3;
		
		g_ImpulseTime_ms = (g_REGULATOR_CYCLETIME_SEC * 10) * g_flRegPercentOn;
		
		impHigh_TimeMs = g_ImpulseTime_ms;
		impLow_TimeMs = (g_REGULATOR_CYCLETIME_SEC * 1000)-100 - impHigh_TimeMs;

		// Открытие клапана дозации
		restTimeMs = impHigh_TimeMs;
		if( restTimeMs > 100 )
			switch_VALVE(1);
		while( restTimeMs > 0 ) {
			delayMs = restTimeMs > 1000 ? 1000: restTimeMs + 1;
			vTaskDelay( delayMs );
			restTimeMs -= delayMs;
			g_WdtKlapan = 1;
		}
		
		// Закрытие клапана дозации
		restTimeMs = impLow_TimeMs;
		switch_VALVE(0);
		while( restTimeMs > 0 ) {
			delayMs = restTimeMs > 1000 ? 1000: restTimeMs + 1;
			vTaskDelay( delayMs );
			restTimeMs -= delayMs;
			g_WdtKlapan = 1;
		}
		
		xCurrTicks = xTaskGetTickCount();
		
		if( g_REGULATOR_CYCLETIME_SEC * 1000 > ( xCurrTicks - xLastWakeTime ) )
		{			
			xTickToNextCycle = (g_REGULATOR_CYCLETIME_SEC * 1000) - (xCurrTicks - xLastWakeTime);
		}
		else
		{
			xTickToNextCycle = 10;
		}
			
		// Wait for the next cycle.
		vTaskDelayUntil( &xLastWakeTime, xTickToNextCycle );
	}
}

void SaveRegulatorValue( float setup_PH, float value )
{
	int index = 0;
	if( setup_PH < 5 )	index = 2;
	else if( setup_PH < 6 )	index = 1;
	
	g_OptTablePoints[index].ph_setup_user = roundf( setup_PH * 10 );
	g_OptTablePoints[index].reg_value_opt_calc = value * 10;
	
	FM24_WriteBytes( EEADR_OPT_TABLE, (uint8_t*) &g_OptTablePoints, sizeof(g_OptTablePoints) );
}

/*******************************************************
Поток		: Рабочий поток устройства
Параметр 1	: не используется
Возвр. знач.: бесконечный цикл
********************************************************/
void Thread_Regulator( void *pvParameters )
{
	const int REG_WUp_Time = 100; // время между циклами работы потока в мс.
//	const int TIMEOUT_DELAY_CALC_PID = 10000;	// время задержки начала расчета PID
	
	TickType_t xLastWakeTime;
	int timeOutErrorPhValue = 0;
	int timeOutErrorPhSensors = 0;
	int timeValuePhIsGood = 0;
	int countAvgValues;
	float sumRegValue;

	bool IsPhSensorsTooDiff;
	//bool is_WaterOk_curr;

	g_WdtRegulator = 1;
	Reg_Init();

	g_isNoWater = true;

	vTaskDelay( 2500 );
	g_WdtRegulator = 1;
	vTaskDelay( 2500 );
	g_WdtRegulator = 1;

	xTaskCreate( Thread_Klapan, (const char*)"Klapan", configMINIMAL_STACK_SIZE, ( void * ) NULL, ( tskIDLE_PRIORITY + 1 ), NULL);
	//xTaskCreate( Thread_Pid, (const char*)"Pid", configMINIMAL_STACK_SIZE,	( void * ) NULL, ( tskIDLE_PRIORITY + 1 ), NULL);

					 
	TimerRegulatorStartDelay = xTimerCreate("TimerRegulator", g_TIMEOUT_REGULATOR_ON_SEC > 0 ? (g_TIMEOUT_REGULATOR_ON_SEC * 1000) : 10,
                     pdTRUE, 		// The timers will auto-reload themselves when they expire.
                     ( void * ) 0,	// The ID
                     OnTimerRegulatorStartDelay );

//	TimerCalcPid = xTimerCreate("TimerCalcPid", TIMEOUT_DELAY_CALC_PID,
//                     pdTRUE, 		// The timers will auto-reload themselves when they expire.
//                     ( void * ) 0,	// The ID
//                     OnTimerCalcPid );
					 
	// Initialise the xLastWakeTime variable with the current time.
	xLastWakeTime = xTaskGetTickCount();
	for(;;)
	{
		g_WdtRegulator = 1;
		
		// Wait for the next cycle.
		vTaskDelayUntil( &xLastWakeTime, REG_WUp_Time );

		// Проверка режима работы
		if( ReadWorkMode(0) != Mode_RegulatorPh || g_isErrSensors || g_isErrTimeoutSetupPh )
		{
			// Если не в режиме регулирования, отключаем насос и ждем 
			if( IsPumpTurnON() )
				switch_PUMP(0); 
			continue;
		}
		
		// Здесь мы в режиме регулирования, ошибок нет

		// Проверка воды
		if( g_isNoWater != !IsWaterOk() )
		{
			// Проверяем изменение наличия воды
			g_isNoWater = !IsWaterOk();
			
			if( g_isNoWater ) {
				// вода пропала
				Regulator_STOP();
				
				// добавлен сброс давления при пропадании воды методом открытия клапана на 3 сек.
				//portENTER_CRITICAL();
				
// Удалено для 2.01
//				for( int i=0; i<30; i++ )
//				{
//					switch_VALVE(1);
//					vTaskDelay(100);
//					g_WdtRegulator = 1;
//				}
				switch_VALVE(0);
				//portEXIT_CRITICAL();
			}
			else {
				// вода появилась, начинаем новый полив.
				Regulator_START();

				// После включения насоса открываем дозатор на 0,5 сек чтобы сбросить вакуум
				// блокируем переключение потоков чтобы никто не мог переключить клапан кроме вызвавшего функцию
				//portENTER_CRITICAL();

// Удалено для 2.01
//				switch_VALVE( 1 );
//				vTaskDelay(300);
//				switch_VALVE( 0 );
				//portEXIT_CRITICAL();
			}
			continue;
		}
		
		if( g_isNoWater ) {
			// если нет воды, просто ждем
			continue;
		}

		if( !IsPumpTurnON() )
			switch_PUMP(1); // Включаем насос
			
		// Тут у нас вода есть, насос включен, задержка регулирования кончилась. Регулируем.
		
		// проверяем ошибки по датчикам PH и выводим на дисплей значения PH
		g_Sensor_PH = AInp_GetSystemPh( &IsPhSensorsTooDiff );
		if( g_Sensor_PH < 0 || IsPhSensorsTooDiff )
		{
			if( !g_isErrSensors )
			{
				timeOutErrorPhSensors  += REG_WUp_Time;
				if( timeOutErrorPhSensors > TIMEOUT_SENSORS_TOO_DIFF_MS )
				{
					g_isErrSensors = true;
					timeOutErrorPhSensors = 0;
				}
			}
		}
		else
		{
			timeOutErrorPhSensors = 0;
		}

		if( fabs( g_Sensor_PH - g_Setup_PH ) > MAX_PH_DELTA_FOR_ERROR )
		{
			timeOutErrorPhValue += REG_WUp_Time;
			if( timeOutErrorPhValue > ((uint32_t)g_TIMEOUT_ERROR_PH_SEC * 1000ul) )
			{
				timeOutErrorPhValue = 0;
				g_isErrTimeoutSetupPh = true;
			}
		}
		else 
		{
			timeOutErrorPhValue = 0;
		}
		if( fabs( g_Sensor_PH - g_Setup_PH ) < 0.2 )
		{
			timeValuePhIsGood += REG_WUp_Time;
			countAvgValues++;
			sumRegValue += g_flRegPercentOn;
			if( timeValuePhIsGood > 60000 )
			{
				timeValuePhIsGood = 0;
				// здесь надо сохранить положение регулятора в таблицу оптимальных значений
				float avgRegValue = sumRegValue;
				avgRegValue /= countAvgValues;
				SaveRegulatorValue( g_Setup_PH, avgRegValue );
			}
		}
		else 
		{
			countAvgValues = 0;
			sumRegValue = 0;
			timeValuePhIsGood = 0;
		}
	}
}

/*******************************************************
	Чтение коэффициентов PID регулятора
********************************************************/
int Reg_ReadCoefficient( uint16_t idx )
{
	int value = -1;
	switch( idx )
	{
		case 0:
			value = g_K_PROP * 1000;
			break;
		case 1:
			value = g_K_INTEGRAL * 1000;
			break;
		case 2:
			value = g_K_DIFF * 1000;
			break;
		default:
			value = -1;
			break;
	}
	
	return value;
}

/*******************************************************
	Запись коэффициентов PID регулятора
********************************************************/
bool Reg_WriteCoefficient( uint16_t idx, uint16_t val )
{
	if( idx > 2 )
		return false;
	
	uint16_t ee_addr = EEADR_COEF_PROP + idx * sizeof(uint16_t);
	// сохраняем в EEPROM
	bool isWrited = FM24_WriteBytes( ee_addr, (uint8_t*) &val, 2 );
	
	if( isWrited )
	{
		switch( idx )
		{
			case 0:
				g_K_PROP = (float)val  / 1000.0;
				break;
			case 1:
				g_K_INTEGRAL = (float)val  / 1000.0;
				break;
			case 2:
				g_K_DIFF = (float)val  / 1000.0;
				break;
			default:
				break;
		}
	}
	
	return isWrited;
}

/*******************************************************
	Чтение максимального времени отсутствия воды
********************************************************/
int Reg_Read_TIMEOUT_REGULATOR_ON_SEC( uint16_t idx )
{
	int ivalue = g_TIMEOUT_REGULATOR_ON_SEC; 
	
	return ivalue;
}

/*******************************************************
	Чтение максимального времени регулировки PH до ошибки
********************************************************/
int Reg_Read_TIMEOUT_ERROR_PH_SEC( uint16_t idx )
{
	int ivalue = g_TIMEOUT_ERROR_PH_SEC; 
	
	return ivalue;
}

/*******************************************************
	Запись максимального времени отсутствия воды
********************************************************/
bool Reg_Write_TIMEOUT_REGULATOR_ON_SEC( uint16_t idx, uint16_t val )
{
	// сохраняем в EEPROM
	bool isWrited = FM24_WriteWords( EEADR_TIMEOUT_REGULATOR_ON_SEC, &val, 1 );

	if( isWrited )
	{
		g_TIMEOUT_REGULATOR_ON_SEC = val;
	}
	
	return isWrited;
}

/*******************************************************
	Запись максимального времени регулировки PH до ошибки
********************************************************/
bool Reg_Write_TIMEOUT_ERROR_PH_SEC( uint16_t idx, uint16_t val )
{
	// сохраняем в EEPROM
	bool isWrited = FM24_WriteWords( EEADR_TIMEOUT_ERROR_PH_SEC, &val, 1 );

	if( isWrited )
	{
		g_TIMEOUT_ERROR_PH_SEC = val;
	}
	
	return isWrited;
}

int Reg_Read_DELAY_PUMP_OFF_SEC( uint16_t idx )
{
	return g_DELAY_PUMP_OFF_SEC;
}
bool Reg_Write_DELAY_PUMP_OFF_SEC( uint16_t idx, uint16_t val )
{
	if( val > 10 ) val = 10;
	
	// сохраняем в EEPROM
	bool isWrited = FM24_WriteWords( EEADR_DELAY_PUMP_OFF_SEC, &val, 1 );

	if( isWrited )
	{
		g_DELAY_PUMP_OFF_SEC = val;
	}
	
	return isWrited;
	
}

/*******************************************************
	Чтение времени хода регуятора PH
********************************************************/
int Reg_Read_REG_CYCLETIME_SEC( uint16_t idx )
{
	int ivalue = g_REGULATOR_CYCLETIME_SEC; 
	
	return ivalue;
}

/*******************************************************
	Чтение одного из регистров мониторинга текущего состояния
********************************************************/
int Reg_Read_MonitoringValue( uint16_t idx )
{
	int ivalue = -1;
	
	EMonitoringType type = (EMonitoringType) idx;
	
	switch( type )
	{
		case MON_IsNoWater:
			ivalue = g_isNoWater;
			break;
		case MON_IsErrSensors:
			ivalue = g_isErrSensors;
			break;
		case MON_IsErrTimeoutSetupPh:
			ivalue = g_isErrTimeoutSetupPh;
			break;
		case MON_PH_Setup:
			ivalue = g_Setup_PH * 100;
			break;
		case MON_PH1_Current:
			ivalue = AInp_ReadPhValue(0);
			break;
		case MON_PH2_Current:
			ivalue = AInp_ReadPhValue(1);
			break;
		
		case MON_RegPercentOn:
			ivalue = fabs( roundf( g_flRegPercentOn * 100 ) );
			break;
		case MON_PID_Value:
			ivalue = fabs( g_PID_Value ) * 100;
			break;
		case MON_PID_Positive:
			ivalue = g_PID_Value >= 0 ? 1 : 0; 
			break;
		case MON_DeltaPercent:
			ivalue = fabs( roundf( g_flDeltaPercent * 100 ));
			break;
		case MON_DeltaPercentPositive:
			ivalue = g_flDeltaPercent >= 0 ? 1 : 0; 
			break;
		case MON_ImpulseTime_ms:
			ivalue = abs( g_ImpulseTime_ms );
			break;
	}
	
	return ivalue;
}


/*******************************************************
	Запись времени хода регуятора PH
********************************************************/
bool Reg_Write_REG_CYCLETIME_SEC( uint16_t idx, uint16_t val )
{
	if( val < MIN_REG_CYCLETIME_SEC )
		val = MIN_REG_CYCLETIME_SEC;
	else if( val > MAX_REG_CYCLETIME_SEC )
		val = MAX_REG_CYCLETIME_SEC;
	
	// сохраняем в EEPROM
	bool isWrited = FM24_WriteWords( EEADR_REG_CYCLETIME_SEC, &val, 1 );

	if( isWrited )
	{
		g_REGULATOR_CYCLETIME_SEC = val;
	}
	
	return isWrited;
}

int Reg_OptValues_Read( uint16_t idx )
{
	
	switch( idx )
	{
		case 0: return g_OptTablePoints[0].ph_setup_def;
		case 1: return g_OptTablePoints[0].reg_value_opt_def;
		case 2: return g_OptTablePoints[0].ph_setup_user;
		case 3: return g_OptTablePoints[0].reg_value_opt_calc;
		case 4: return g_OptTablePoints[1].ph_setup_def;
		case 5: return g_OptTablePoints[1].reg_value_opt_def;
		case 6: return g_OptTablePoints[1].ph_setup_user;
		case 7: return g_OptTablePoints[1].reg_value_opt_calc;
		case 8: return g_OptTablePoints[2].ph_setup_def;
		case 9: return g_OptTablePoints[2].reg_value_opt_def;
		case 10: return g_OptTablePoints[2].ph_setup_user;
		case 11: return g_OptTablePoints[2].reg_value_opt_calc;
		default : break;
	}
	return -1;
}

bool Reg_OptValues_Write( uint16_t idx, uint16_t val )
{
	bool result = false;
	
	if( idx != 1 && idx != 5 && idx != 9 )
		return false;
	
	uint16_t eeAddr = EEADR_OPT_TABLE + (idx*2);
	
	result = FM24_WriteWords( eeAddr, &val, 1 );
	if( result )
	{
		if( idx == 1 ) 		g_OptTablePoints[0].reg_value_opt_def = val;
		else if( idx == 5 ) g_OptTablePoints[1].reg_value_opt_def = val;
		else if( idx == 9 ) g_OptTablePoints[2].reg_value_opt_def = val;
	}
	return result;
}
