melitvinov/Acidifier/SOFT/Sources/Rs485.c

/***********************************************************************************
* Наименование модуля	: Модуль связи по шине RS-485
*-----------------------------------------------------------------------------------
* Версия				: 1.0
* Автор					: Тимофеев
* Дата создания			: 23.05.2018
************************************************************************************/

//--- INCLUDES -------------------
#include "Rs485.h"

#include "FreeRTOS.h"
#include "queue.h"
#include "task.h"

//#include "Modbus.h"

// --- DEFINES -------------------

// --- TYPES ---------------------

//--- CONSTANTS ------------------

//--- GLOBAL VARIABLES -----------
int g_I;

//--- EXTERN ---------------------
//extern TPacketBuffer OneMbusMessage;
//extern EMBusState MbusState;
//extern bool IsPacketReady;
extern void On_Usart_ReceiveChar( char chr );

//--- IRQ ------------------------

/*******************************************************
Прерывание по событию от USART1
********************************************************/
void USART1_IRQHandler(void)
{
	if( USART1->SR & USART_IT_RXNE ) //прерывание по приему данных
	{
		if ((USART1->SR & (USART_FLAG_NE|USART_FLAG_FE|USART_FLAG_PE)) == 0) //проверяем нет ли ошибок
		{
			uint16_t data = USART_ReceiveData(USART1);
			
			On_Usart_ReceiveChar( data & 0xFF); //считываем данные в буфер
		}
		else
		{
			// Ошибка приема
			USART_ReceiveData(USART1);
		}
	}
}

//--- FUNCTIONS ------------------

/*******************************************************
Функция		: Инициализация RS-485
Параметр 1	: нет
Возвр. знач.: нет
********************************************************/
void Rs485_Init(void)
{
	// Инициализация сигнала Read/Write
	// Перевод вывода RW на выход с открытым коллектором
	GPIO_PinConfigure( PORT_RS485_RW, OUT_RS485_RW, GPIO_OUT_PUSH_PULL, GPIO_MODE_OUT2MHZ );
    // Установка сигнала чтения
	GPIO_PinWrite( PORT_RS485_RW, OUT_RS485_RW, 0 );
	
	// Инициализация USART1
	
	RCC->APB2ENR |= RCC_APB2ENR_USART1EN;
	USART1->BRR = USART_BRR_9600;		// Baudrate for 9600 on 8Mhz (833)
	USART1->CR1  |= USART_CR1_UE | USART_CR1_TE | USART_CR1_RE | USART_CR1_RXNEIE; // USART1 ON, TX ON, RX ON, RXNE Int ON

	RCC->APB2ENR  	|= RCC_APB2ENR_IOPAEN | RCC_APB2ENR_AFIOEN; 	// GPIOA Clock ON. Alter function clock ON
	
	GPIOA->CRH	&= ~GPIO_CRH_CNF9; 				// Clear CNF bit 9
	GPIOA->CRH	|= GPIO_CRH_CNF9_1;				// Set CNF bit 9 to 10 - AFIO Push-Pull
	GPIOA->CRH	|= GPIO_CRH_MODE9_0;				// Set MODE bit 9 to Mode 01 = 10MHz
	
	GPIOA->CRH	&= ~GPIO_CRH_CNF10;	// Clear CNF bit 9
	GPIOA->CRH	|= GPIO_CRH_CNF10_0;	// Set CNF bit 9 to 01 = HiZ
	GPIOA->CRH	&= ~GPIO_CRH_MODE10;	// Set MODE bit 9 to Mode 01 = 10MHz

	NVIC_EnableIRQ (USART1_IRQn);
	__enable_irq ();
}

/*******************************************************
Функция		: Переключение RS-485 на запись
Параметр 1	: нет
Возвр. знач.: нет
********************************************************/
void prvRs485_ToWrite(void)
{
	GPIO_PinWrite( PORT_RS485_RW, OUT_RS485_RW, 1 );
	vTaskDelay(DELAY_BEFORE_SEND);
}

/*******************************************************
Функция		: Переключение RS-485 на чтение
Параметр 1	: нет
Возвр. знач.: нет
********************************************************/
void prvRs485_ToRead(void)
{
	vTaskDelay(DELAY_AFTER_SEND);
	GPIO_PinWrite( PORT_RS485_RW, OUT_RS485_RW, 0 );
}
	
/*******************************************************
Функция		: Отправка символа в USART1
Параметр 1	: отправляемый символ
Возвр. знач.: нет
********************************************************/
void prvUsart1_Send( char chr )
{
	while(!(USART1->SR & USART_SR_TXE)) {}

	USART1->DR = chr;

	while(!(USART1->SR & USART_SR_TXE)) {}
}

/*******************************************************
Функция		: Отправка буфера в RS-485
Параметр 1	: отправляемый буфер
Параметр 2	: длина буфера в символах
Возвр. знач.: нет
********************************************************/
void RS485_SendBuf( TPacketBuffer * buffer )
{
	if( !buffer )
		return;
	
	prvRs485_ToWrite();
	
	for( g_I=0; g_I<buffer->msgLen; g_I++ )
	{
		prvUsart1_Send( buffer->msgData[g_I] );
	}

	prvRs485_ToRead();
}

void RS485_SendString( char * szString )
{
	if( !szString )
		return;
	
	prvRs485_ToWrite();
	
	while( *szString != 0 )
	{
		prvUsart1_Send( *szString );
		szString++;
	}

	prvRs485_ToRead();
}
