melitvinov/Acidifier/SOFT/Sources/Regulator.h

/***********************************************************************************
* Заголовочный файл для	: Управление регулятором PH
*
************************************************************************************/

#ifndef __REGULATOR_H_
#define __REGULATOR_H_

//--- INCLUDES -------------------
#include "stdio.h"
#include "math.h"
#include "stdlib.h"

#include "GPIO_STM32F10x.h"
#include "stm32f10x.h"
#include "Board.h"

#include "FreeRTOS.h"
#include "task.h"
#include "timers.h"

// --- DEFINES -------------------
#define REL_ON	(0) // логический уровень для включения реле
#define REL_OFF	(1)	// логический уровень для отключения сегмента

// --- TYPES ---------------------

#pragma pack(push,1)

typedef struct _relay_desc
{
	GPIO_TypeDef *GPIOx;
	uint16_t pin;
} TRelDesc;

typedef struct _opt_table_point
{
	uint16_t ph_setup_def;
	uint16_t reg_value_opt_def;
	uint16_t ph_setup_user;
	uint16_t reg_value_opt_calc;
} TOptTablePoint;

#pragma pack(pop)

//--- FUNCTIONS ------------------
void Reg_Init(void);

void Thread_Regulator( void *pvParameters );

int Reg_ReadCoefficient( uint16_t idx );
bool Reg_WriteCoefficient( uint16_t idx, uint16_t val );

int Reg_Read_TIMEOUT_REGULATOR_ON_SEC( uint16_t idx );
int Reg_Read_TIMEOUT_ERROR_PH_SEC( uint16_t idx );
bool Reg_Write_TIMEOUT_REGULATOR_ON_SEC( uint16_t idx, uint16_t val );
bool Reg_Write_TIMEOUT_ERROR_PH_SEC( uint16_t idx, uint16_t val );

int Reg_Read_REG_CYCLETIME_SEC( uint16_t idx );
bool Reg_Write_REG_CYCLETIME_SEC( uint16_t idx, uint16_t val );

int Reg_Read_DELAY_PUMP_OFF_SEC( uint16_t idx );
bool Reg_Write_DELAY_PUMP_OFF_SEC( uint16_t idx, uint16_t val );

int Reg_OptValues_Read( uint16_t idx );
bool Reg_OptValues_Write( uint16_t idx, uint16_t val );


typedef enum __monitoring_types
{
	MON_IsNoWater	 		= 1,			// флаг - отсутствие воды (0-1)
	MON_IsErrSensors 		= 2,			// флаг - ошибка датчиков
	MON_IsErrTimeoutSetupPh	= 3,			// флаг - ошибка регулирования

	MON_PH_Setup			= 4,			// установленное значение PH
	MON_PH1_Current			= 5,			// текущее значение PH1
	MON_PH2_Current			= 6,			// текущее значение PH2
	
	MON_RegPercentOn 		= 7,			// процент открытия регулятора (0-100)
	MON_PID_Value 			= 8,			// текущее значение значение PID * 100;
	MON_PID_Positive 		= 9,			// знак PID ( 1 - плюс, 0 - минус )
	MON_DeltaPercent 		= 10,			// текущее значение уменьшения или увеличения процента открытия
	MON_DeltaPercentPositive= 11,			// знак DeltaPercent ( 1 - плюс, 0 - минус )
	MON_ImpulseTime_ms 		= 12,			// длительность открытия клапана в мс.
} EMonitoringType;

int Reg_Read_MonitoringValue( uint16_t idx );	// чтение одного из регистров мониторинга текущего состояния

//void Reg_RestartWaterTimer(void);
void Regulator_START(void);
bool IsPumpTurnON( void );

#endif
