melitvinov/Acidifier/(commit log)

2021-03-05 Добавлены схемы и платы подкислителя
    [Acidifier - LCD.PCB, Acidifier - LCD.SCH, Acidifier.PCB, Acidifier.SCH]
2021-03-10 Добавлен софт, первый коммит
    [Acidifier - LCD.PCB, Acidifier.PCB]
2021-03-11 Добавлен почти весь функционал
2021-03-12 Сделан регулятор и режим калибровки датчиков
2021-03-16 Доработки и переделки
    [Acidifier - LCD v2.PCB, Acidifier - LCD.PCB, Acidifier - LCD.SCH, Acidifier - LCD_v2.SCH, Перечень элементов Acidifier LCD v2.xlsx, Перечень элементов Acidifier.xlsx]
2021-03-24 Документация на новые платы версии v2. Доработки софта
    [Acidifier-v2.SCH, Acidifier-v2.pcb, Acidifier.PCB, Acidifier.SCH, Перечень элементов Acidifier v2.xlsx, Перечень элементов Acidifier.xlsx]
2021-03-25 Доработки разные
2021-03-26 Доделана функция проверки регулятора
2021-03-31 Доработан регулятор PH
2021-04-01 Немного изменен алгоритм регулирования
2021-04-02 Разные доработки
2021-04-02 Прерывистый режим работы регулятора заменен на непрерывный, расчет PID каждые 200 мс.
2021-04-14 Немного доработан софт, выложена документация в PCAD
    [Acidifier - LCD v2.PCB, Acidifier - LCD_v2.SCH, Acidifier - LCD_v3.SCH, Acidifier - LCD_v3.pcb, Acidifier-v2.SCH, Acidifier-v2.pcb, Acidifier-v3.SCH, Acidifier-v3.pcb]
2021-04-28 Изменен алгоритм регулирования
2021-05-13 Вернул проверки ошибок
2021-06-02 Сделан алгоритм для снятия хар-ки дозатора
2021-06-02 Импульсное регулирование. Требуется тестирование на железе и воде
2021-07-16 Переделан алгоритм вычисления коррекции по PH
2021-07-21 Доработана регулировка, добавлена фильтрация значений pH, сделана новая плата
    [Acidifier-v3.SCH, Acidifier-v3.pcb, Acidifier-v4.SCH, Acidifier-v4.pcb, Перечень элементов Acidifier v4.xlsx, Перечень элементов Acidifier-v3.xlsx]
2021-07-27 Теперь при отсутствии воды регулирование останавливается немедленно, а после появления - задержка, и регулировка в течение 15 сек. с тем же коэффициентом как завершился предыдущий полив.
2021-07-27 Доработка под версию платы Acidifier-v4.pcb
2021-07-27 Небольшие правки для светодиодов и реле
2021-07-28 Системный светодиод теперь отображает номер устройства, небольшие правки кода
    [Перечень элементов Acidifier v4.xlsx]
2021-08-05 Добавлен тип устройства "Product_Id.h" и версия прошивки в название hex файла
2021-12-22 Добавлено Описание подкислителя.docx
2022-01-25 Добавлено описание регистров и картинка из ПО DeviceSetup
2022-01-25 Устранены некоторые косяки алгоритма
2022-01-26 Начало изменений алгоритма по новому заданию (по данным тестирования на объекте)
2022-01-27 Добавлены задержки: включения регулирования, включения расчета PID, отключения насоса
2022-01-28 Добавлены регистры для чтения таблицы оптимальных значений регулятора
2022-01-31 Версия 1.03. Изменен порядок (нумерация регистров)
2022-02-01 Добавлен сторожевой таймер
2022-02-03 Поправлена документация
2022-02-16 Ограничен минимум открытия регулятора до 3%, максимум PID до +-30, и сделан старт с половины сохраненного значения положения регулятора
2022-02-25 Отключена авария по разнице датчиков PH
2022-02-25 Устранена одна неточность
2022-02-25 Временно отменена авария по разнице датчиков PH (v1.04)
2022-03-02 Версия 1.05. Доработка для сброса вакуума при включении и выключении насоса
    [Acidifier-v4.pcb, Acidifier-v5.SCH, Acidifier-v5.pcb, Acidifier-v6.SCH, Acidifier-v6.pcb]
2022-03-03 Немного изменен алгоритм дозации (длина цикла зафиксирована = 3 сек.)
2022-03-03 Небольшие доработки v1.06
2022-03-22 Переделана формула PID. Версия 1.07
2022-06-09 Доработка документации
    [Acidifier-v4.SCH, Acidifier-v5.SCH, Acidifier-v5.pcb, Acidifier-v6.pcb, Перечень элементов Acidifier v4.xlsx, Перечень элементов Acidifier v6.xlsx]
2022-07-18 Сброс вакуума открытием клапана на 3 сек. после отключения воды
2022-08-01 Добавлены BOM файлы
    [BOM_Acidifier - LCD_v3.xlsx, BOM_Acidifier-v6.xlsx]
2022-08-03 Подправлен BOM_Acidifier-v6.xlsx
    [BOM_Acidifier-v6.xlsx]
2022-12-27 Изменена плата (замена реле) ver. 7
    [Acidifier-v7.pcb]
2023-09-21 Удалил hex версии 1.07. Текущая версия 1.08
2023-10-03 Прошивка 1.09. Отменена фиксация времени цикла дозации 3 сек. Теперь значение берется из настроек
2023-10-04 Версия 2.01. Убрано лишнее, подправлено нужное
2023-10-04 Версия 2.01. Изменены константы max min уровня открытия регулятора 0-100%. Изменен таймаут ошибки сенсоров pH на 30 сек.
2023-10-04 Версия 2.01. Исправлена инициализация коэффициентов PID при загрузке
    [Regulator.c]
2023-12-05 Фиксация для платы Acidifier-v7
    [Acidifier-v6.pcb, Acidifier-v7.pcb, BOM_Acidifier - LCD v3.xlsx, BOM_Acidifier - LCD_v3.xlsx, BOM_Acidifier-v6.xlsx, BOM_Acidifier-v7.xlsx, Перечень элементов Acidifier v6.xlsx, Перечень элементов Acidifier-v7.xlsx]
